t0mpr1c3/magicmouth/README.md

magicmouth
==========

Arduino speech shield http://www.tinyurl.com/magicmouth/
