t0mpr1c3/magicmouth/hardware/v1.0/magicmouth-v1.0-schematic.png

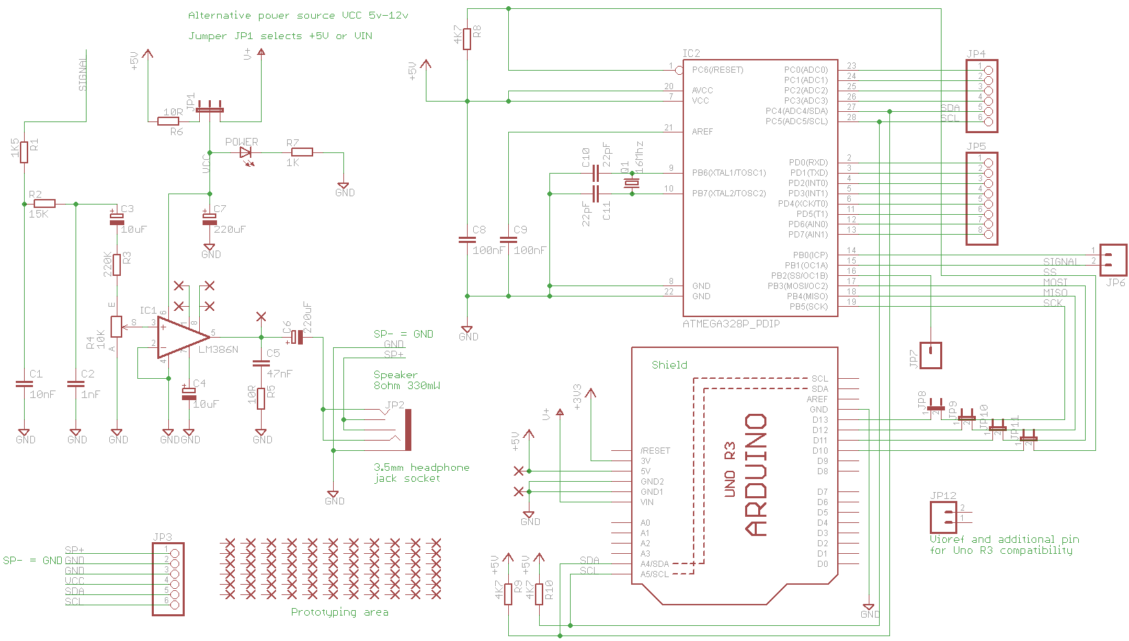
hardware/v1.0/magicmouth-v1.0-schematic.png
