t0mpr1c3/magicmouth/hardware/v1.0/magicmouth-v1.0.brd

## EAGLE design hardware/v1.0/magicmouth-v1.0.brd (2013-02-01)

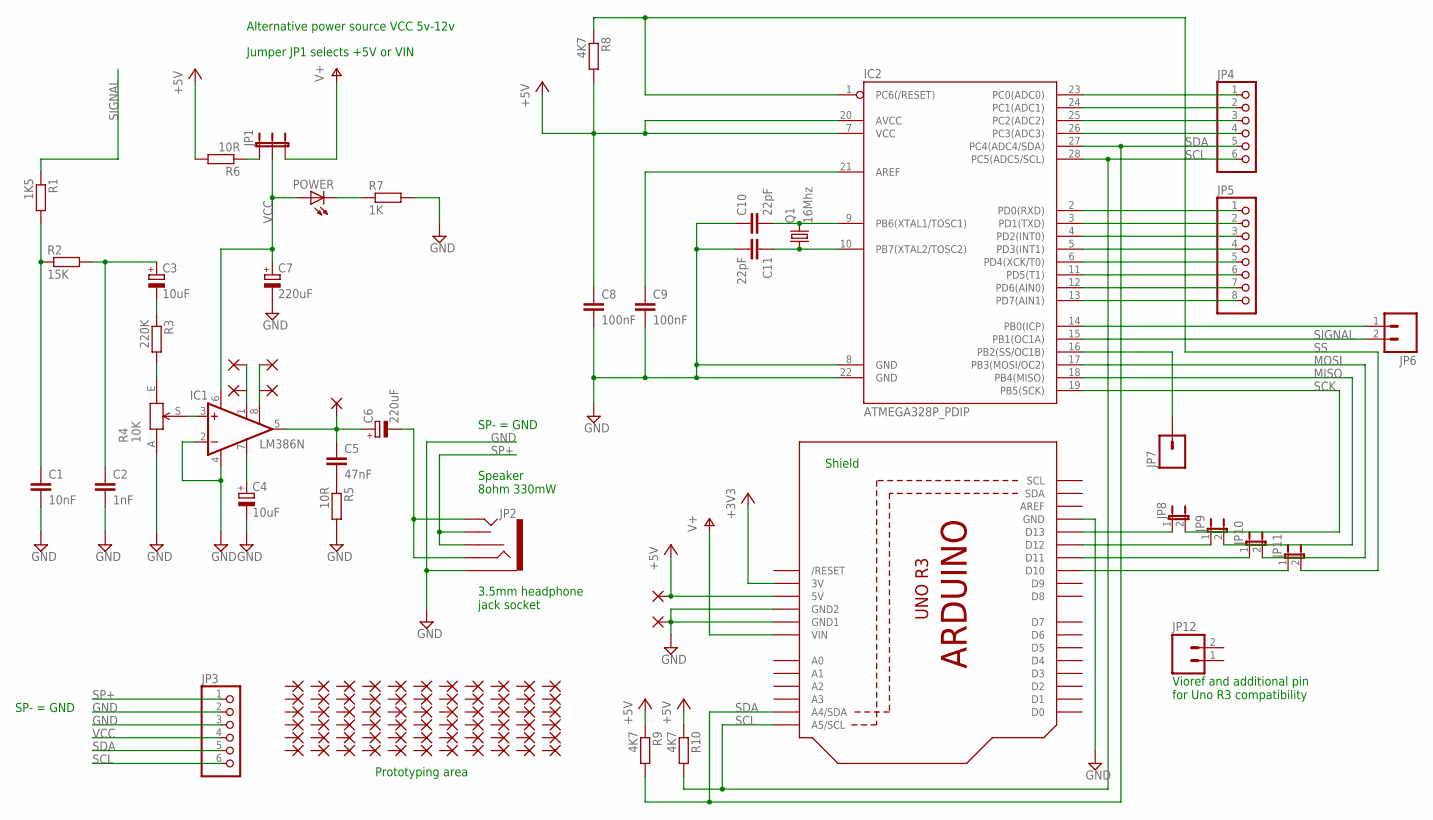
[picture p2: schematic magicmouth-v1.0.sch]

Parts:
C1: 10nF; C050-025X075
C2: 1nF; C050-025X075
C3, C4: 10uF; E2,5-7
C5: 47nF; C050-025X075
C6, C7: 220uF; TT2D7
C8, C9: 100nF; C025-025X050
C10, C11: 22pF; C025-025X050
IC1: LM386N; DIL08
IC2: ATMEGA328P_PDIP; DIL28-3
JP1: JUMPER-3PTH; 1X03
JP2: AUDIO-JACK2PTH; AUDIO-JACK
JP3, JP4: PINHD-1X6CB; 1X06-CLEANBIG
JP5: PINHD-1X8CLEANBIG; 1X08-CLEANBIG
JP6, JP12: M021X02_NO_SILK; 1X02_NO_SILK
JP7: M01SMDNS; 1X01NS
JP8, JP9, JP10, JP11: JUMPER-2PTH; 1X02
P1, P5, P8: 1,6/0,8
PAD1, PAD3, PAD7, PAD8, PAD9, PAD10, PAD11, PAD12, PAD13, PAD14, PAD15, PAD16, PAD17, PAD18, PAD19, PAD20, PAD21, PAD22, PAD23, PAD24, PAD25, PAD26, PAD27, PAD28, PAD29, PAD30, PAD31, PAD32, PAD33, PAD34, PAD35, PAD36, PAD37, PAD38, PAD39, PAD40, PAD41, PAD42, PAD43, PAD44, PAD45, PAD46, PAD47, PAD48, PAD49, PAD50, PAD51, PAD52, PAD53, PAD54, PAD55, PAD56, PAD57, PAD58, PAD59, PAD60, PAD61, PAD62, PAD63, PAD64, PAD65, PAD66, PAD67, PAD68, PAD69, PAD70, PAD71, PAD72, PAD73, PAD74: 1,6/0,8
POWER: LED3MM
Q1: 16Mhz; HC49/S
R1: 1K5; 0207/7
R2: 15K; 0207/7
R3: 220K; 0207/7
R4: 10K; 3352T
R5, R6: 10R; 0207/7
R7: 1K; 0207/7
R8, R9, R10: 4K7; 0207/7
U1: ARDUINOR3-NOIOREF-NOTEXT; ARDUINOR3-NOTEXT-NOIOREF

Connections:
+3V3: U1.3V
+5V: C8.1, IC2.7 (VCC), IC2.20 (AVCC), PAD55.1, R6.2, R8.2, R9.1, R10.1, U1.5V
D8: IC2.14 (PB0(ICP)), JP6.1
GND: C1.2, C2.2, C4.-, C7.-, C8.2, C9.2, C10.1, C11.2, IC1.2 (-IN), IC1.4 (GND), IC2.8 (GND), IC2.22 (GND), JP2.SLEEVE, JP3.2, JP3.3, PAD68.1, R4.A, R5.2, R7.2, U1.GND, U1.GND1, U1.GND2
MISO: IC2.18 (PB4(MISO)), JP9.2
MOSI: IC2.17 (PB3(MOSI/OC2)), JP10.2
unnamed: C5.1, C6.+, IC1.5 (OUT), P5.1
unnamed: C1.1, R1.2, R2.1
unnamed: C9.1, IC2.21 (AREF)
unnamed: C5.2, R5.1
unnamed: R3.2, R4.E
unnamed: C10.2, IC2.9 (PB6(XTAL1/TOSC1)), Q1.2
unnamed: JP1.1, R6.1
unnamed: C6.-, JP2.RING, JP2.TIP
unnamed: IC1.3 (+IN), R4.S
unnamed: POWER.K (C), R7.1
unnamed: C11.1, IC2.10 (PB7(XTAL2/TOSC2)), Q1.1
unnamed: IC2.16 (PB2(SS/OC1B)), JP7.1
unnamed: IC2.23 (PC0(ADC0)), JP4.1
unnamed: C2.1, C3.+, R2.2
unnamed: IC2.24 (PC1(ADC1)), JP4.2
unnamed: IC2.2 (PD0(RXD)), JP5.1
unnamed: IC2.3 (PD1(TXD)), JP5.2
unnamed: IC2.4 (PD2(INT0)), JP5.3
unnamed: IC2.5 (PD3(INT1)), JP5.4
unnamed: IC2.6 (PD4(XCK/T0)), JP5.5
unnamed: IC2.11 (PD5(T1)), JP5.6
unnamed: IC2.12 (PD6(AIN0)), JP5.7
unnamed: IC2.13 (PD7(AIN1)), JP5.8
unnamed: C4.+, IC1.7 (BYPASS)
unnamed: IC2.25 (PC2(ADC2)), JP4.3
unnamed: IC2.26 (PC3(ADC3)), JP4.4
unnamed: IC1.1 (GAIN), P1.1, PAD1.1
unnamed: C3.-, R3.1
unnamed: JP8.1, U1.D13
unnamed: JP9.1, U1.D12
unnamed: JP10.1, U1.D11
unnamed: JP11.1, U1.D10
unnamed: IC1.8 (GAIN), P8.1, PAD3.1
SCK: IC2.19 (PB5(SCK)), JP8.2
SCL: IC2.28 (PC5(ADC5/SCL)), JP3.6, JP4.6, R10.2, U1.A5 (A5/SCL)
SDA: IC2.27 (PC4(ADC4/SDA)), JP3.5, JP4.5, R9.2, U1.A4 (A4/SDA)
SIGNAL: IC2.15 (PB1(OC1A)), JP6.2, R1.1
SP+: JP2.RSH, JP2.TSH, JP3.1
SS: IC2.1 (PC6(/RESET)), JP11.2, R8.1
VCC: C7.+, IC1.6 (VS), JP1.2, JP3.4, POWER.A
VIN: JP1.3, U1.VIN

Notes on the sheet:
Speaker 8ohm 330mW
Jumper JP1 selects +5V or VIN
Alternative power source VCC 5v-12v
Shield
3.5mm headphone jack socket
Prototyping area
SP- = GND
Vioref and additional pin for Uno R3 compatibility

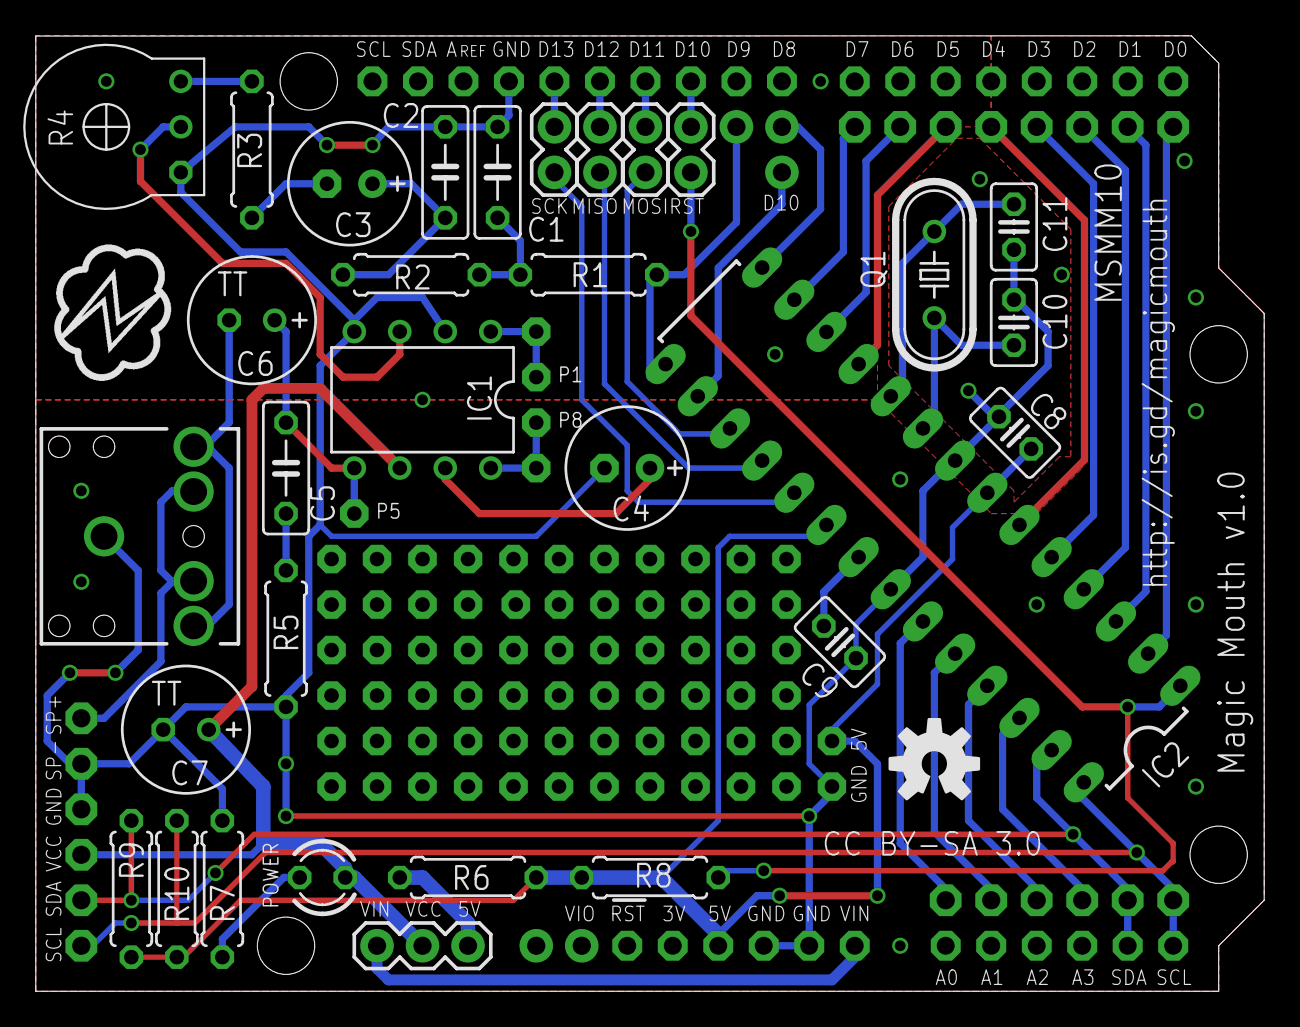
[picture p3: board magicmouth-v1.0.brd from above]

Board: 2 copper layers, 68.6 x 53.3 mm, 113 parts (1 on the bottom side), 46 nets.

Other parts of the board:
U$1, U$2: OSHW-LOGO-M
