t0mpr1c3/magicmouth/hardware/v0.1/magicmouth-v0.1.brd

## EAGLE design hardware/v0.1/magicmouth-v0.1.brd (2012-12-21, an earlier design)

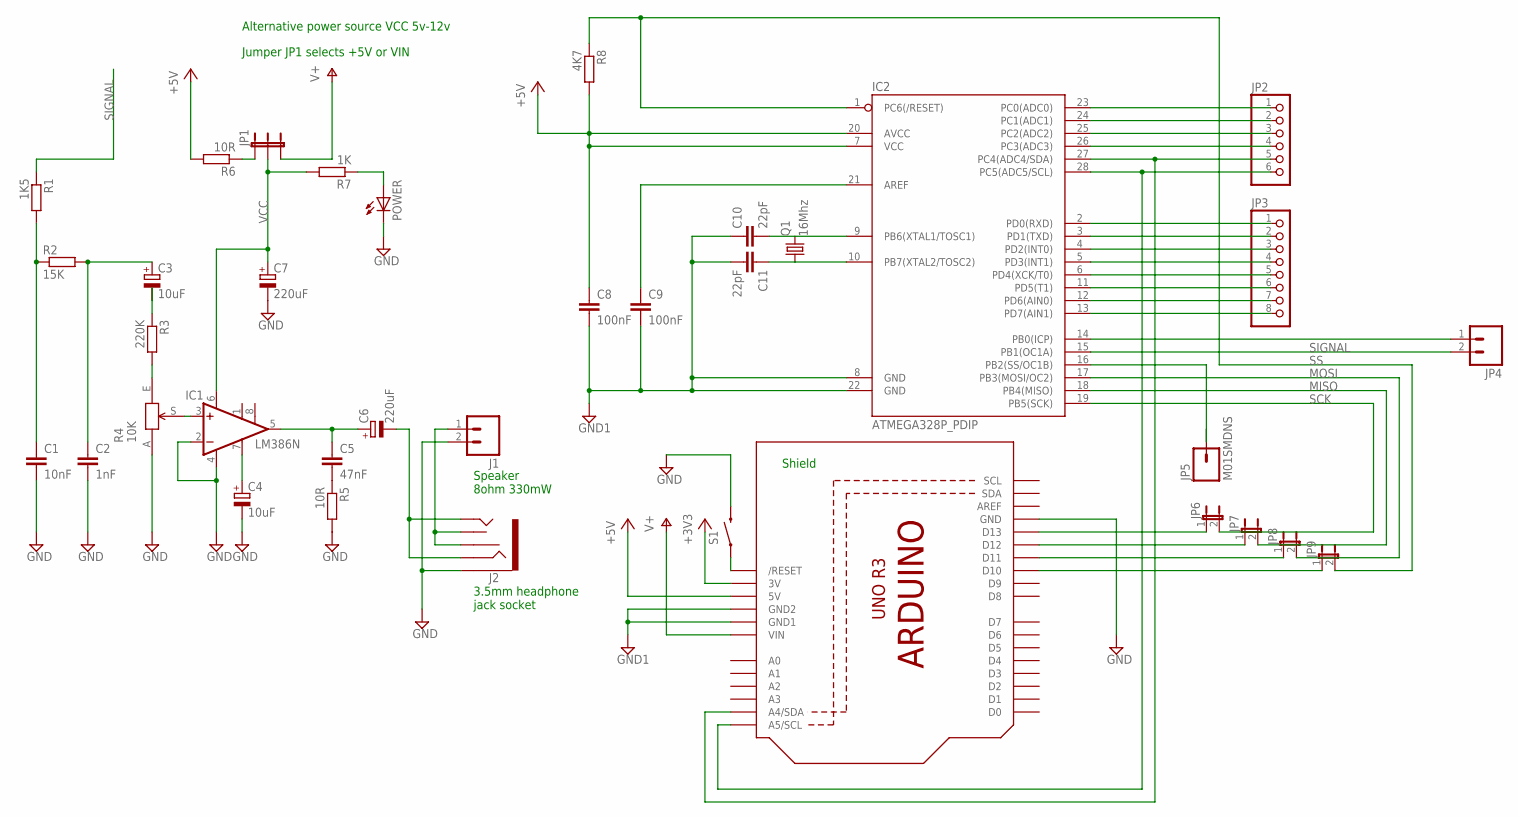
[picture p4: schematic magicmouth-v0.1.sch]

Parts:
C1: 10nF; C050-025X075
C2: 1nF; C050-025X075
C3, C4: 10uF; E2,5-7
C5: 47nF; C050-025X075
C6, C7: 220uF; TT5D7L
C8, C9: 100nF; C025-025X050
C10, C11: 22pF; C025-025X050
IC1: LM386N; DIL08
IC2: ATMEGA328P_PDIP; DIL28-3
J1: M023.5MM; SCREWTERMINAL-3.5MM-2
J2: AUDIO-JACK2PTH; AUDIO-JACK
JP1: JUMPER-3PTH; 1X03
JP2: PINHD-1X6CB; 1X06-CLEANBIG
JP3: PINHD-1X8CLEANBIG; 1X08-CLEANBIG
JP4: M021X02_NO_SILK; 1X02_NO_SILK
JP5: M01SMDNS; 1X01NS
JP6, JP7, JP8, JP9: JUMPER-2PTH; 1X02
POWER: LED3MM
Q1: 16Mhz; HC49/S
R1: 1K5; 0207/7
R2: 15K; 0207/7
R3: 220K; 0207/7
R4: 10K; 3352T
R5, R6: 10R; 0207/7
R7: 1K; 0207/7
R8: 4K7; 0207/7
S1: SWITCH-MOMENTARY-2PTH; TACTILE-PTH
U1: ARDUINOR3-NOIOREF-NOTEXT; ARDUINOR3-NOTEXT-NOIOREF

Connections:
+3V3: U1.3V
+5V: C8.1, IC2.7 (VCC), IC2.20 (AVCC), R6.2, R8.2, U1.5V
GND: C1.2, C2.2, C4.-, C7.-, IC1.2 (-IN), IC1.4 (GND), J1.2, J2.SLEEVE, POWER.K (C), R4.A, R5.2, S1.3 (2), U1.GND
GND1: C8.2, C9.2, C10.1, C11.2, IC2.8 (GND), IC2.22 (GND), U1.GND1, U1.GND2
MISO: IC2.18 (PB4(MISO)), JP7.2
MOSI: IC2.17 (PB3(MOSI/OC2)), JP8.2
unnamed: C5.1, C6.+, IC1.5 (OUT)
unnamed: C1.1, R1.2, R2.1
unnamed: J1.1, J2.RSH, J2.TSH
unnamed: C5.2, R5.1
unnamed: C3.-, R3.1
unnamed: C10.2, IC2.9 (PB6(XTAL1/TOSC1)), Q1.2
unnamed: JP1.1, R6.1
unnamed: C6.-, J2.RING, J2.TIP
unnamed: IC1.3 (+IN), R4.S
unnamed: POWER.A, R7.1
unnamed: C11.1, IC2.10 (PB7(XTAL2/TOSC2)), Q1.1
unnamed: IC2.16 (PB2(SS/OC1B)), JP5.1
unnamed: IC2.23 (PC0(ADC0)), JP2.1
unnamed: IC2.24 (PC1(ADC1)), JP2.2
unnamed: IC2.25 (PC2(ADC2)), JP2.3
unnamed: IC2.2 (PD0(RXD)), JP3.1
unnamed: IC2.3 (PD1(TXD)), JP3.2
unnamed: IC2.4 (PD2(INT0)), JP3.3
unnamed: IC2.5 (PD3(INT1)), JP3.4
unnamed: IC2.6 (PD4(XCK/T0)), JP3.5
unnamed: IC2.11 (PD5(T1)), JP3.6
unnamed: IC2.12 (PD6(AIN0)), JP3.7
unnamed: IC2.13 (PD7(AIN1)), JP3.8
unnamed: IC2.14 (PB0(ICP)), JP4.1
unnamed: JP6.1, U1.D13
unnamed: JP7.1, U1.D12
unnamed: IC2.26 (PC3(ADC3)), JP2.4
unnamed: JP8.1, U1.D11
unnamed: JP9.1, U1.D10
unnamed: IC2.27 (PC4(ADC4/SDA)), JP2.5, U1.A4 (A4/SDA)
unnamed: IC2.28 (PC5(ADC5/SCL)), JP2.6, U1.A5 (A5/SCL)
unnamed: C2.1, C3.+, R2.2
unnamed: C4.+, IC1.7 (BYPASS)
unnamed: C9.1, IC2.21 (AREF)
unnamed: S1.1, U1.RESET (/RESET)
unnamed: R3.2, R4.E
SCK: IC2.19 (PB5(SCK)), JP6.2
SIGNAL: IC2.15 (PB1(OC1A)), JP4.2, R1.1
SS: IC2.1 (PC6(/RESET)), JP9.2, R8.1
VCC: C7.+, IC1.6 (VS), JP1.2, R7.2
VIN: JP1.3, U1.VIN

Notes on the sheet:
Speaker 8ohm 330mW
Jumper JP1 selects +5V or VIN
Alternative power source VCC 5v-12v
Shield
3.5mm headphone jack socket

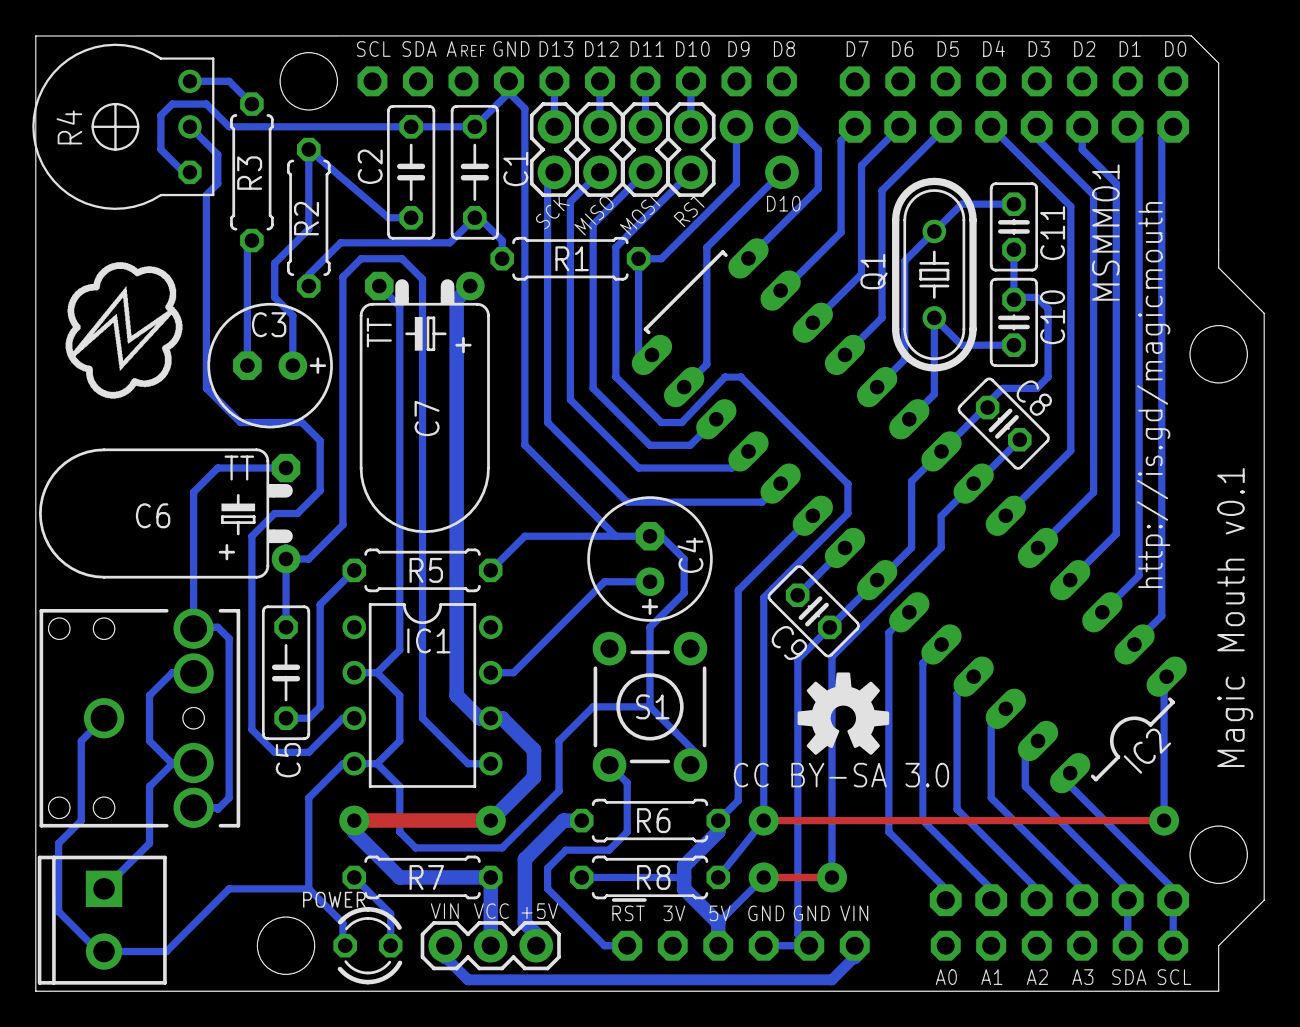
[picture p5: board magicmouth-v0.1.brd from above]

Board: 2 copper layers, 68.6 x 53.3 mm, 37 parts (0 on the bottom side), 46 nets.

Other parts of the board:
U$1: OSHW-LOGO-M
