t0mpr1c3/magicmouth/(commit log)

2012-11-28 magicmouth-v0.1 eagle files and webbotlib project file
    [magicmouth-v0.1-ds.brd, magicmouth-v0.1-ds.sch, magicmouth-v0.1-ss.brd, magicmouth-v0.1-ss.sch]
2012-11-30 added 5V jumper to v0.1 single sided board
    added 5V jumper to v0.1 single sided board
    added 5V jumper to v0.1 single sided board
    added 5V jumper to v0.1 single sided board
    added 5V jumper to v0.1 single sided board
    [magicmouth-v0.1-ds.brd, magicmouth-v0.1-ss.brd]
2012-12-04 added programming jumpers
    [magicmouth-v0.1-ds.brd, magicmouth-v0.1-ds.sch, magicmouth-v0.1-ss.brd, magicmouth-v0.1-ss.sch]
2012-12-05 reset switch on ss board; optional capacitor
    [magicmouth-v0.1-ds.brd, magicmouth-v0.1-ds.sch, magicmouth-v0.1-ss.brd, magicmouth-v0.1-ss.sch]
2012-12-10 220K resistor in series with gain control
    [magicmouth-v0.1-ds.brd, magicmouth-v0.1-ds.sch, magicmouth-v0.1-ss.brd, magicmouth-v0.1-ss.sch]
2012-12-14 connected reset button to GND not +5V
    [magicmouth-v0.1-ss.brd, magicmouth-v0.1-ss.sch]
2012-12-18 vertical 220uF caps, 6 pin IO header
    [magicmouth-v0.1-ds.brd, magicmouth-v0.1-ds.sch]
2012-12-18 adjusted placement to avoid through holes directly above Arduino USB port
    [magicmouth-v0.1-ds.brd, magicmouth-v0.1-ss.brd, magicmouth-v0.1-ss.sch]
2012-12-19 substituted atmega328p, added logo
    [magicmouth-v0.1-ds.brd, magicmouth-v0.1-ss.brd]
2012-12-20 trace corrections
    [magicmouth-v0.1-ds.brd, magicmouth-v0.1-ds.sch, magicmouth-v0.1-ss.brd, magicmouth-v0.1-ss.sch]
2012-12-20 v0.1 and v1.0 eagle files
    [magicmouth-v0.1.brd, magicmouth-v0.1.sch, magicmouth-v1.0.brd, magicmouth-v1.0.sch]
2012-12-20 wide power traces, toner transfer images
    [magicmouth-v0.1.brd, magicmouth-v1.0.brd]
2012-12-20 v0.1-ss and v0.1-ds removed
    [magicmouth-v0.1-ds.brd, magicmouth-v0.1-ds.sch, magicmouth-v0.1-ss.brd, magicmouth-v0.1-ss.sch]
2012-12-21 10uf bypass cap for LM386
    [magicmouth-v0.1.brd, magicmouth-v0.1.sch, magicmouth-v1.0.brd, magicmouth-v1.0.sch]
2012-12-21 vias, isolated ground planes around crystal, gerbers
    [magicmouth-v0.1.brd, magicmouth-v0.1.sch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]
2012-12-23 firmware initial commit
    [magicmouth-v1.0.GBL, magicmouth-v1.0.GBO, magicmouth-v1.0.GBP, magicmouth-v1.0.GBS, magicmouth-v1.0.GTL, magicmouth-v1.0.GTO, magicmouth-v1.0.GTP, magicmouth-v1.0.GTS]
2013-01-05 pullup resistors on SDA and SCL
    [magicmouth-v1.0.brd, magicmouth-v1.0.sch]
2013-01-31 adjusted position of trimpot, enlarged small text
    [magicmouth-v1.0.brd]
2013-02-01 copied magic smoke logo on bottom
    [magicmouth-v1.0.brd]
2013-02-01 change text size for SCK on bottom
    [magicmouth-v1.0.brd]
