t0mpr1c3/magicmouth/(notices)

Notices in the files:
firmware/src/magic_mouth_firmware.c:
This program is free software: you can redistribute it and/or modify
it under the terms of the GNU General Public License as published by
the Free Software Foundation, either version 3 of the License, or
(at your option) any later version.
hardware/v1.0/magicmouth-v1.0.brd:
CC BY-SA 3.0
parts and their libraries:
SparkFun-Connectors: Licensing: CC v3.0 Share-Alike You are welcome to use this library for commercial purposes.
